roy4222/Roy-AmazingHand-SO101/AmazingHand_Enhanced/Demo/docs/finger.png

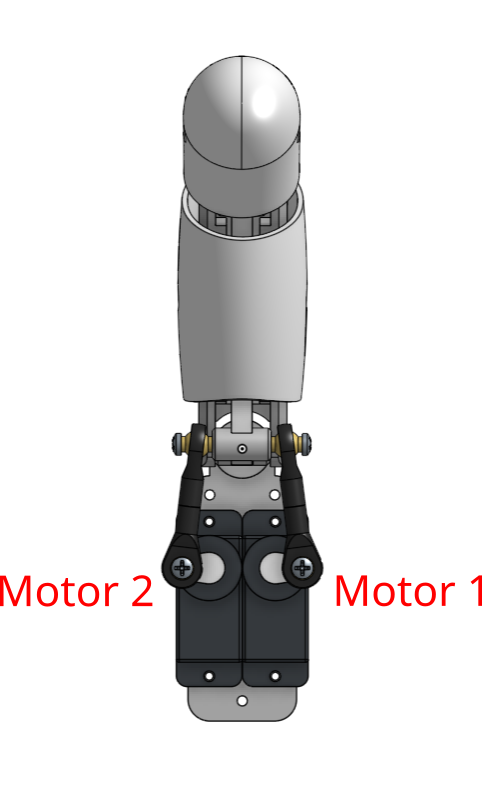
AmazingHand_Enhanced/Demo/docs/finger.png
