roy4222/Roy-AmazingHand-SO101/AmazingHand_Enhanced/Demo/docs/r_hand.png

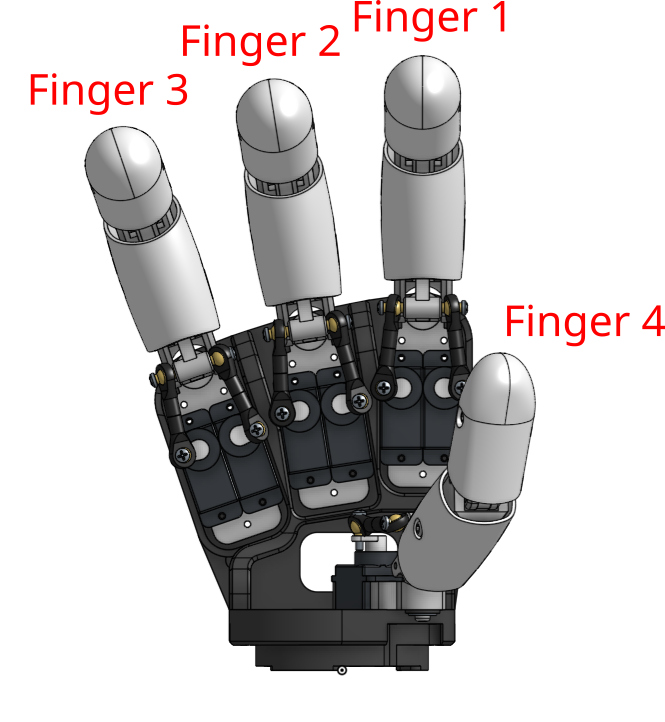
AmazingHand_Enhanced/Demo/docs/r_hand.png
