roy4222/Roy-AmazingHand-SO101/AmazingHand_Enhanced/cad/Step/Amazing Hand Enhanced Parts - R-Hand_Plate.step

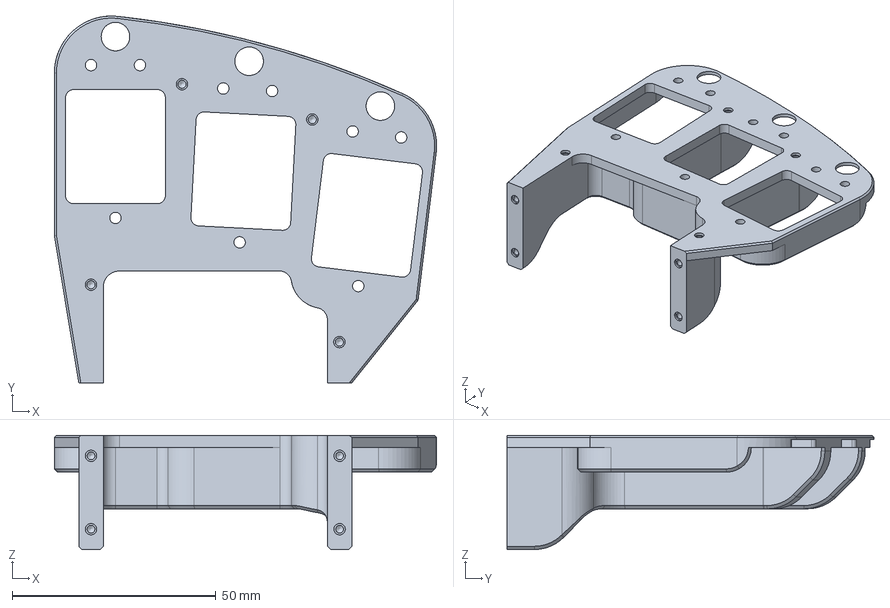
[picture p6: CAD file, 2026-04-02]
AmazingHand_Enhanced/cad/Step/Amazing Hand Enhanced Parts - R-Hand_Plate.step
93.8 x 90.1 x 28.0 mm
