roy4222/Roy-AmazingHand-SO101/AmazingHand_Enhanced/Demo/AHSimulation/AHSimulation/AH_Right/mjcf/assets/distal_shell.stl

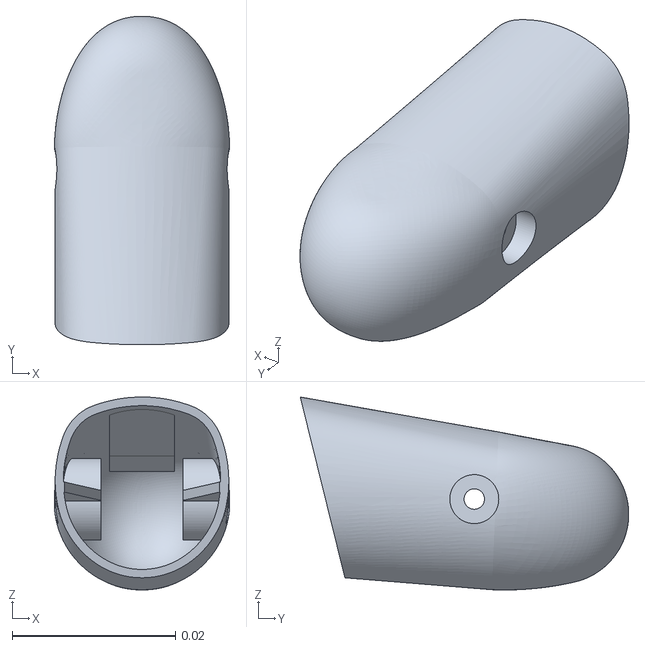
[picture p7: CAD file, 2026-04-08]
AmazingHand_Enhanced/Demo/AHSimulation/AHSimulation/AH_Right/mjcf/assets/distal_shell.stl
0.0215 x 0.0403 x 0.0237
