roy4222/Roy-AmazingHand-SO101/AmazingHand_Enhanced/cad/Step/Amazing Hand Enhanced Parts - Finger_Frame.step

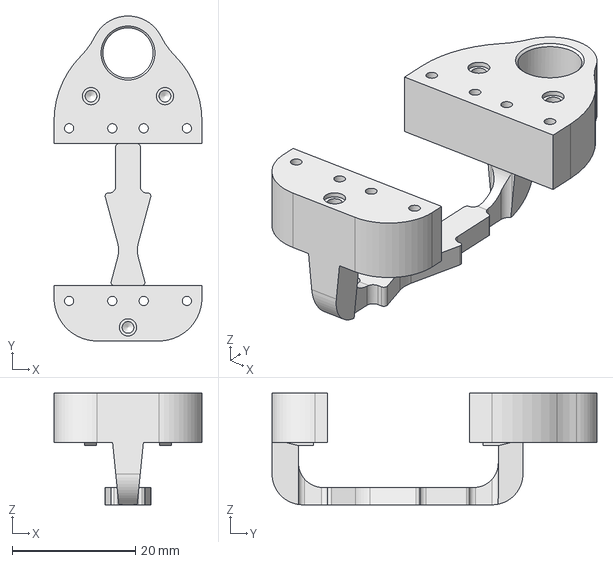
[picture p8: CAD file, 2026-04-02]
AmazingHand_Enhanced/cad/Step/Amazing Hand Enhanced Parts - Finger_Frame.step
24.0 x 52.7 x 18.1 mm
