roy4222/Roy-AmazingHand-SO101/AmazingHand_Enhanced/Demo/AHSimulation/AHSimulation/AH_Left/mjcf/assets/m2_rod_l18.stl

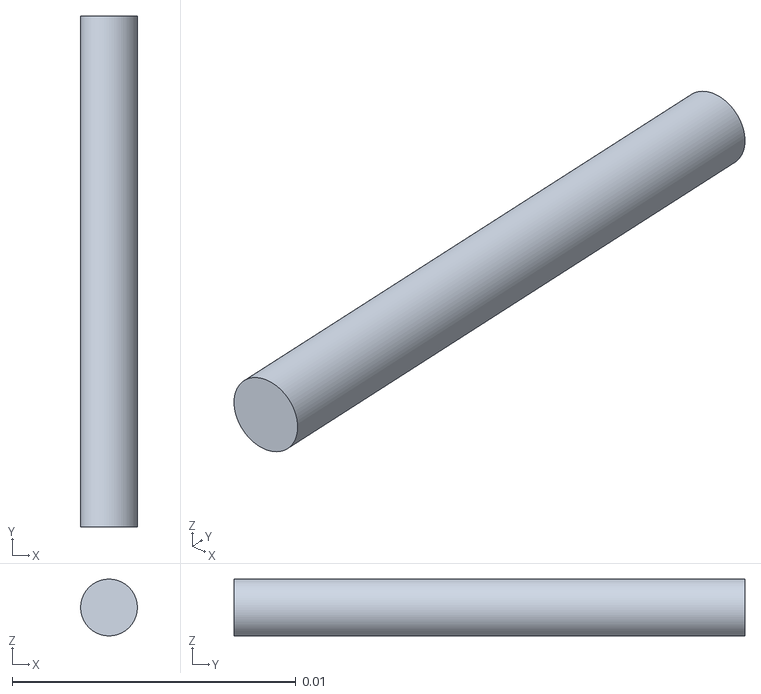
[picture p9: CAD file, 2026-04-08]
AmazingHand_Enhanced/Demo/AHSimulation/AHSimulation/AH_Left/mjcf/assets/m2_rod_l18.stl
0.002 x 0.018 x 0.002
