roy4222/Roy-AmazingHand-SO101/AmazingHand_Enhanced/Demo/AHSimulation/AHSimulation/AH_Right/mjcf/assets/custom_servo_horn.stl

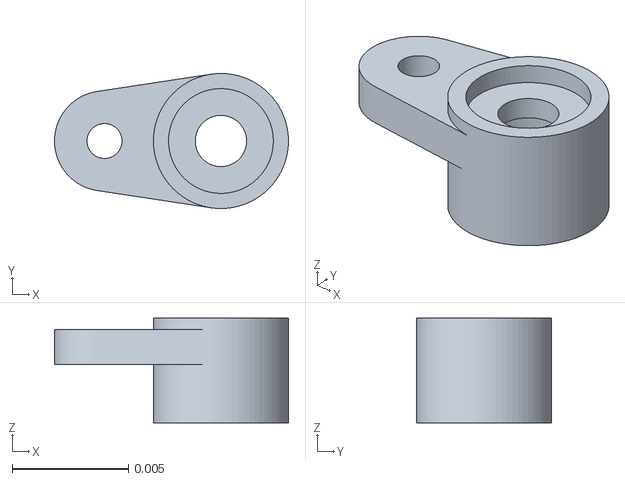
[picture p10: CAD file, 2026-04-08]
AmazingHand_Enhanced/Demo/AHSimulation/AHSimulation/AH_Right/mjcf/assets/custom_servo_horn.stl
0.01 x 0.0058 x 0.0045
