roy4222/Roy-AmazingHand-SO101/AmazingHand_Enhanced/cad/Step/Servo Horn - Custom_Servo-Horn.step

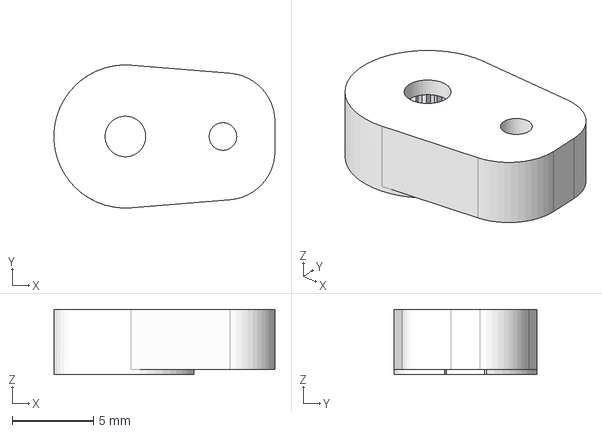
[picture p11: CAD file, 2026-04-02]
AmazingHand_Enhanced/cad/Step/Servo Horn - Custom_Servo-Horn.step
13.6 x 8.79 x 4.00 mm
