roy4222/Roy-AmazingHand-SO101/AmazingHand_Enhanced/Demo/AHSimulation/AHSimulation/AH_Left/mjcf/assets/finger_frame_1.stl

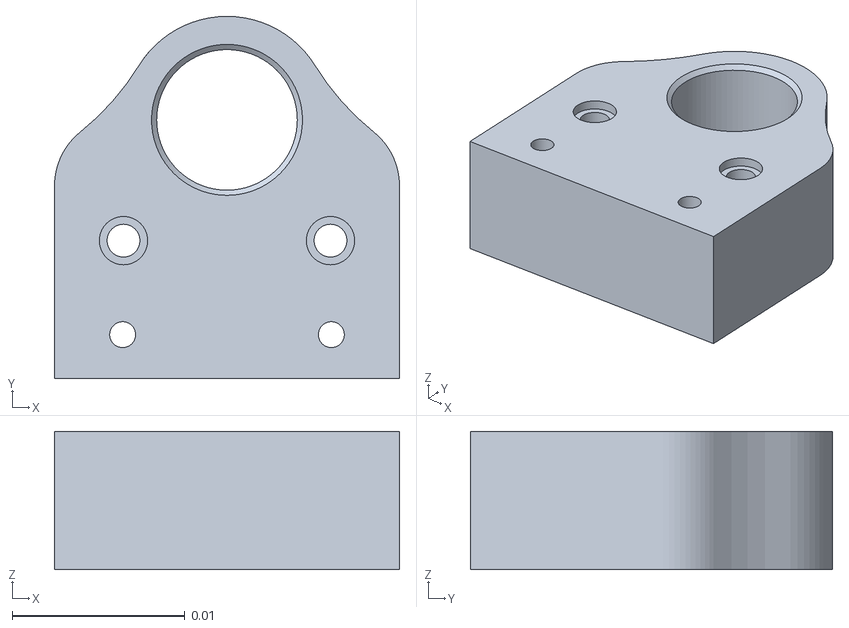
[picture p12: CAD file, 2026-04-08]
AmazingHand_Enhanced/Demo/AHSimulation/AHSimulation/AH_Left/mjcf/assets/finger_frame_1.stl
0.02 x 0.021 x 0.008
