roy4222/Roy-AmazingHand-SO101/AmazingHand_Enhanced/Demo/AHSimulation/AHSimulation/AH_Right/mjcf/assets/link.stl

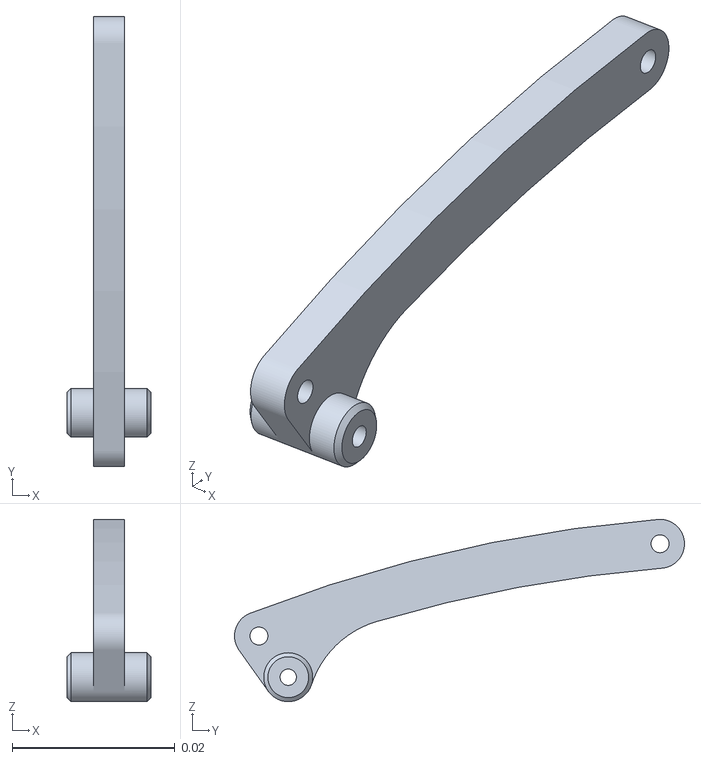
[picture p13: CAD file, 2026-04-08]
AmazingHand_Enhanced/Demo/AHSimulation/AHSimulation/AH_Right/mjcf/assets/link.stl
0.0103 x 0.0552 x 0.0224
