roy4222/Roy-AmazingHand-SO101/AmazingHand_Enhanced/cad/Step/Amazing Hand Enhanced Parts - R-Top_Shell.step

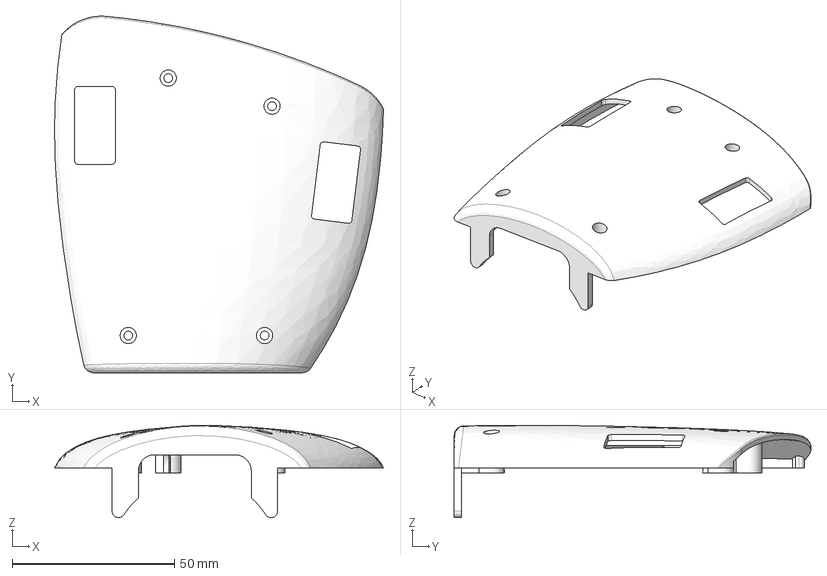
[picture p14: CAD file, 2026-04-02]
AmazingHand_Enhanced/cad/Step/Amazing Hand Enhanced Parts - R-Top_Shell.step
101.4 x 109.9 x 28.4 mm
