roy4222/Roy-AmazingHand-SO101/AmazingHand_Enhanced/Demo/AHSimulation/AHSimulation/AH_Right/mjcf/assets/rotule_lever.stl

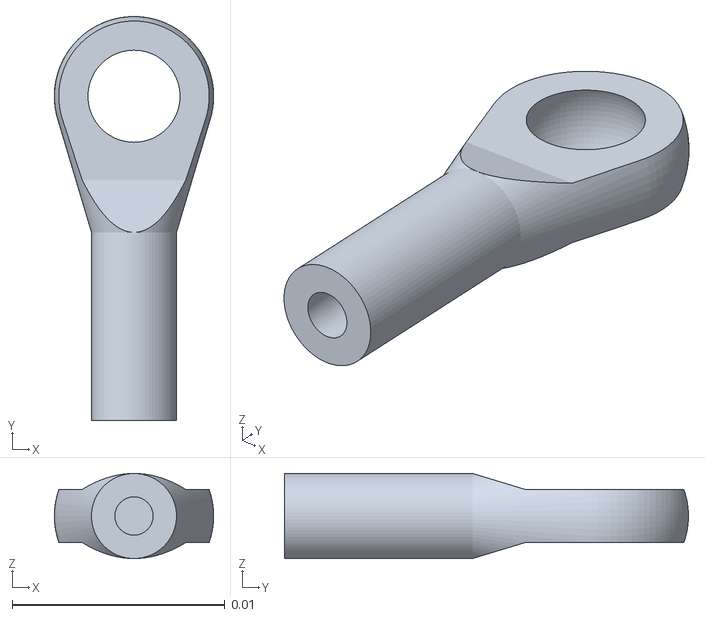
[picture p15: CAD file, 2026-04-08]
AmazingHand_Enhanced/Demo/AHSimulation/AHSimulation/AH_Right/mjcf/assets/rotule_lever.stl
0.0075 x 0.019 x 0.004
