roy4222/Roy-AmazingHand-SO101/AmazingHand_Enhanced/cad/Step/Amazing Hand Enhanced Parts - L-Wrist_Interface.step

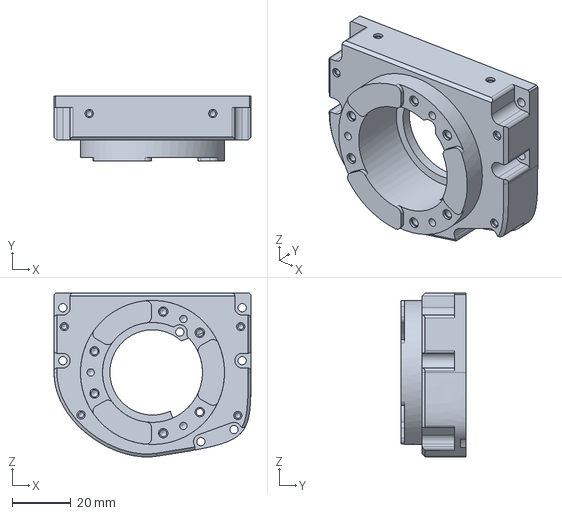
[picture p16: CAD file, 2026-04-02]
AmazingHand_Enhanced/cad/Step/Amazing Hand Enhanced Parts - L-Wrist_Interface.step
67.0 x 22.2 x 55.7 mm
