roy4222/Roy-AmazingHand-SO101/AmazingHand_Enhanced/Demo/AHSimulation/AHSimulation/AH_Left/mjcf/assets/spacer.stl

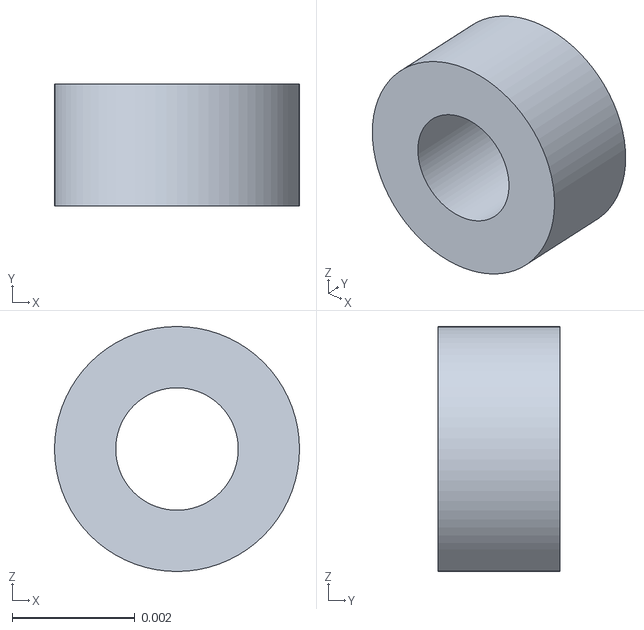
[picture p17: CAD file, 2026-04-08]
AmazingHand_Enhanced/Demo/AHSimulation/AHSimulation/AH_Left/mjcf/assets/spacer.stl
0.004 x 0.002 x 0.004
