roy4222/Roy-AmazingHand-SO101/AmazingHand_Enhanced/Demo/AHSimulation/AHSimulation/AH_Left/mjcf/assets/rotule_ball.stl

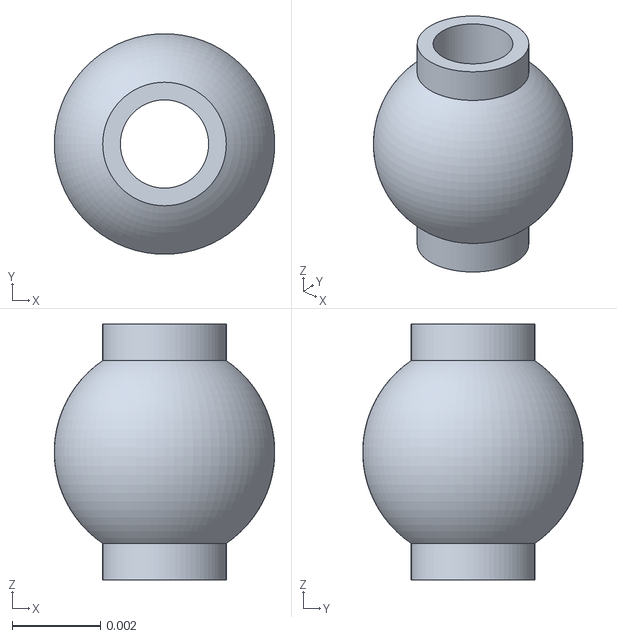
[picture p18: CAD file, 2026-04-08]
AmazingHand_Enhanced/Demo/AHSimulation/AHSimulation/AH_Left/mjcf/assets/rotule_ball.stl
0.005 x 0.005 x 0.0058
