roy4222/Roy-AmazingHand-SO101/AmazingHand_Enhanced/cad/Step/Amazing Hand Enhanced Parts - L-Palm_Shell.step

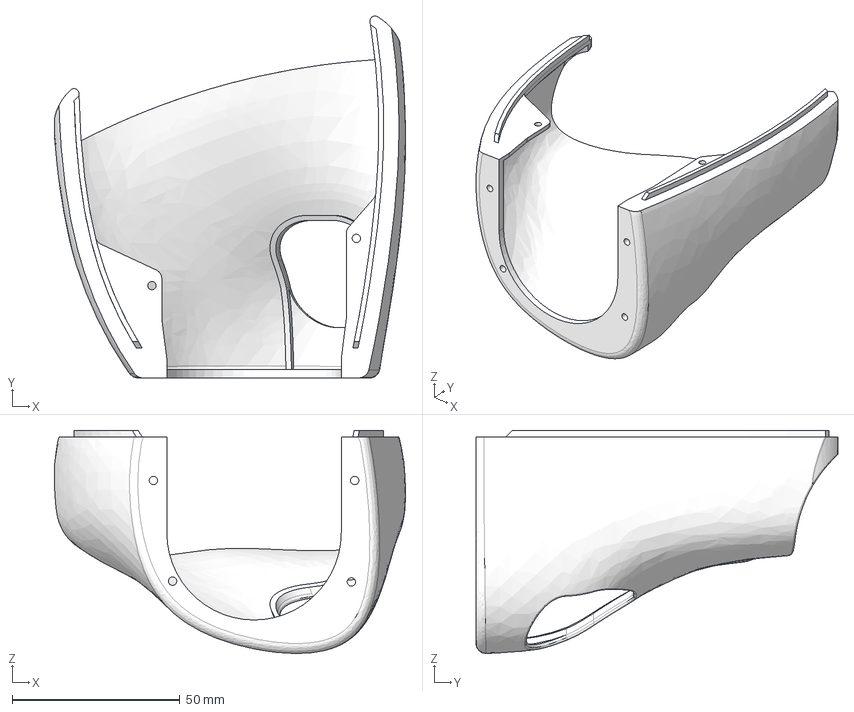
[picture p21: CAD file, 2026-04-02]
AmazingHand_Enhanced/cad/Step/Amazing Hand Enhanced Parts - L-Palm_Shell.step
104.7 x 107.9 x 66.5 mm
