roy4222/Roy-AmazingHand-SO101/AmazingHand_Enhanced/Demo/AHSimulation/AHSimulation/AH_Left/mjcf/assets/l_wrist_interface.stl

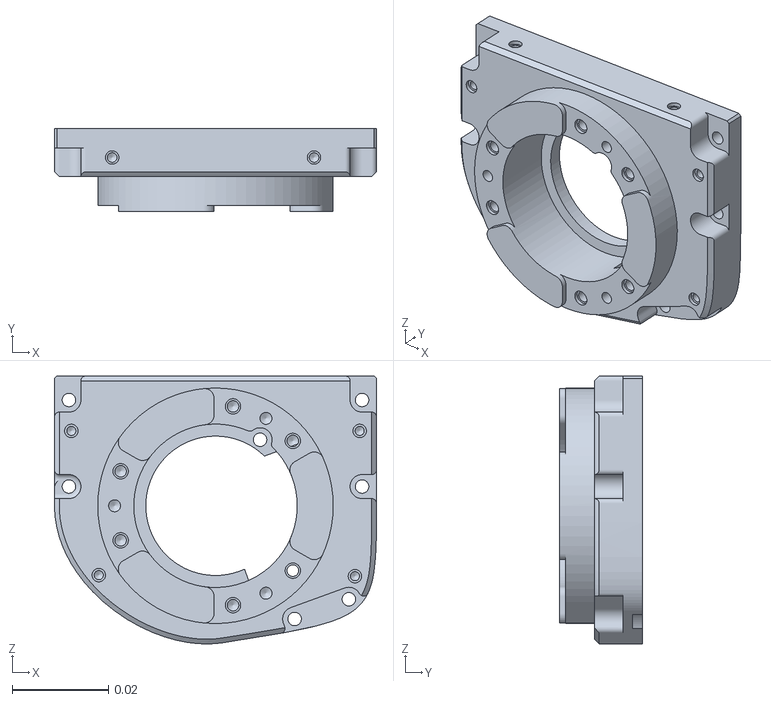
[picture p22: CAD file, 2026-04-08]
AmazingHand_Enhanced/Demo/AHSimulation/AHSimulation/AH_Left/mjcf/assets/l_wrist_interface.stl
0.067 x 0.0172 x 0.0558
