roy4222/Roy-AmazingHand-SO101/AmazingHand_Enhanced/Demo/AHSimulation/AHSimulation/AH_Left/mjcf/assets/parallel_pin_2_x_10__fee063fca0c8b40e46bbc4ffff61d999.stl

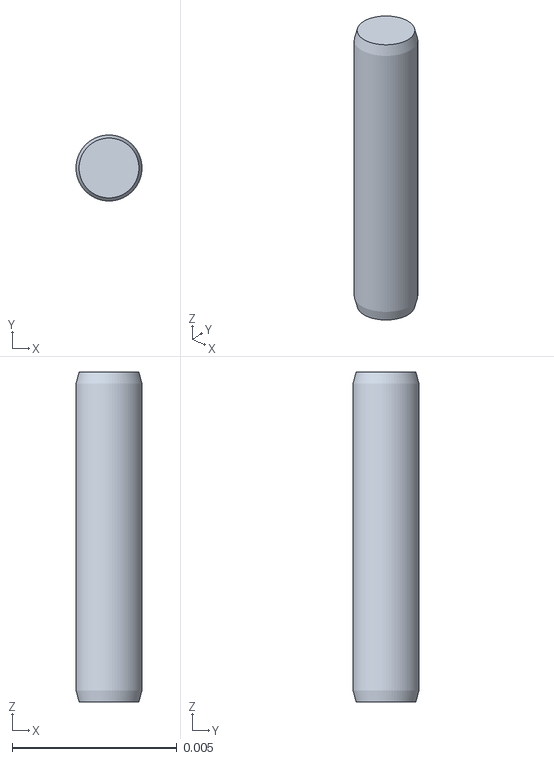
[picture p27: CAD file, 2026-04-08]
AmazingHand_Enhanced/Demo/AHSimulation/AHSimulation/AH_Left/mjcf/assets/parallel_pin_2_x_10__fee063fca0c8b40e46bbc4ffff61d999.stl
0.002 x 0.002 x 0.01
