roy4222/Roy-AmazingHand-SO101/AmazingHand_Enhanced/Demo/AHSimulation/AHSimulation/AH_Right/mjcf/assets/parallel_pin_2_x_16__da4b7ddbe9d803fe3fbc70f2e822b99b.stl

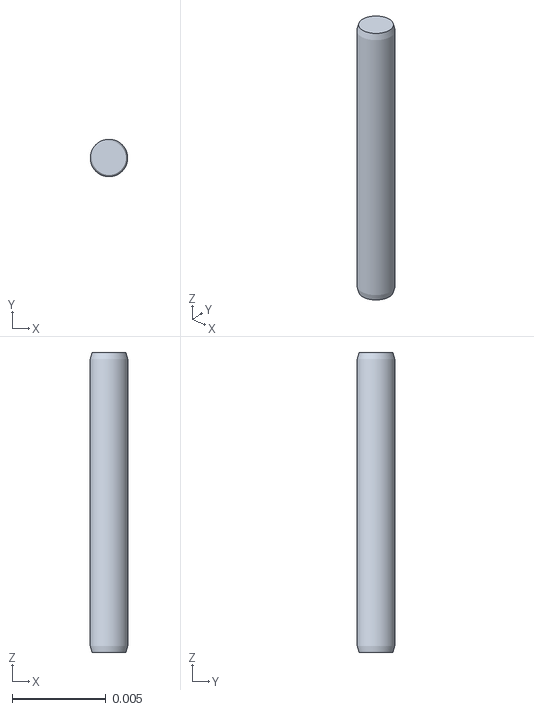
[picture p28: CAD file, 2026-04-08]
AmazingHand_Enhanced/Demo/AHSimulation/AHSimulation/AH_Right/mjcf/assets/parallel_pin_2_x_16__da4b7ddbe9d803fe3fbc70f2e822b99b.stl
0.002 x 0.002 x 0.016
