roy4222/Roy-AmazingHand-SO101/(list of files, cad)

Other CAD files:
AmazingHand_Enhanced/cad/Step/Amazing Hand Enhanced Parts - L-Hand_Plate.step
AmazingHand_Enhanced/cad/Step/Amazing Hand Enhanced Parts - L-Top_Shell.step
AmazingHand_Enhanced/cad/Step/Amazing Hand Enhanced Parts - R-Wrist_Interface.step
AmazingHand_Enhanced/cad/Step/Amazing Hand Enhanced Parts - R-Palm_Shell.step
AmazingHand_Enhanced/Demo/AHSimulation/AHSimulation/AH_Left/mjcf/assets/l_hand_plate.stl
AmazingHand_Enhanced/Demo/AHSimulation/AHSimulation/AH_Right/mjcf/assets/dist.stl
AmazingHand_Enhanced/Demo/AHSimulation/AHSimulation/AH_Right/mjcf/assets/prox.stl
AmazingHand_Enhanced/Demo/AHSimulation/AHSimulation/AH_Right/mjcf/assets/r_wrist_interface.stl
AmazingHand_Enhanced/Demo/AHSimulation/AHSimulation/AH_Left/mjcf/assets/ph_pan_head_screw_m2x0_40_x_10__2803432263e518bbd16bccbbef8784ed.stl
AmazingHand_Enhanced/Demo/AHSimulation/AHSimulation/AH_Left/mjcf/assets/plain_washer_large_grade_a_m2_5__9a369f0dc77bf9c598cdf3fb468977e5.stl
AmazingHand_Enhanced/Demo/AHSimulation/AHSimulation/AH_Left/mjcf/assets/std00333_plast_tcb_torx_2_5x8__configuration_copy_of_default.stl
AmazingHand_Enhanced/Demo/AHSimulation/AHSimulation/AH_Left/mjcf/assets/std00447_thermoplastique_m2_5x6__configuration_default.stl
AmazingHand_Enhanced/Demo/AHSimulation/AHSimulation/AH_Right/mjcf/assets/ph_pan_head_screw_m2x0_40_x_10__2803432263e518bbd16bccbbef8784ed.stl
AmazingHand_Enhanced/Demo/AHSimulation/AHSimulation/AH_Right/mjcf/assets/plain_washer_large_grade_a_m2_5__9a369f0dc77bf9c598cdf3fb468977e5.stl
AmazingHand_Enhanced/Demo/AHSimulation/AHSimulation/AH_Right/mjcf/assets/std00333_plast_tcb_torx_2_5x8__configuration_copy_of_default.stl
AmazingHand_Enhanced/Demo/AHSimulation/AHSimulation/AH_Right/mjcf/assets/std00447_thermoplastique_m2_5x6__configuration_default.stl
AmazingHand_Enhanced/cad/Stl/Amazing Hand Enhanced Parts - Finger_Frame.stl
AmazingHand_Enhanced/cad/Stl/Amazing Hand Enhanced Parts - L-Hand_Plate.stl
AmazingHand_Enhanced/cad/Stl/Amazing Hand Enhanced Parts - L-Top_Shell.stl
AmazingHand_Enhanced/cad/Stl/Amazing Hand Enhanced Parts - L-Wrist_Interface.stl
AmazingHand_Enhanced/cad/Stl/Amazing Hand Enhanced Parts - R-Hand_Plate.stl
AmazingHand_Enhanced/cad/Stl/Amazing Hand Enhanced Parts - R-Top_Shell.stl
AmazingHand_Enhanced/cad/Stl/Amazing Hand Enhanced Parts - R-Wrist_Interface.stl
AmazingHand_Enhanced/cad/Stl/Servo horn - Custom_Servo-Horn.stl
