roy4222/Roy-AmazingHand-SO101/AmazingHand_Enhanced/Demo/AHSimulation/AHSimulation/AH_Left/mjcf/robot.xml

<?xml version="1.0" ?>
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
<mujoco model="mjcf">
  <compiler angle="radian" meshdir="assets" autolimits="true"/>
  <default>
    <default class="mjcf">
      <joint frictionloss="0.1" armature="0.005"/>
      <position kp="50" dampratio="1"/>
      <default class="visual">
        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
      </default>
      <default class="collision">
        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
      </default>
    </default>
  </default>
  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
  <default>
    <default class="perfect_actuator">
      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
      <joint damping="0.095" frictionloss="0.001" armature="0.001" range="-1.5707963267948966 1.5707963267948966"/>
      <position kp="10.0" kv="0.0" forcerange="-10.0 10.0"/>
      <default class="chosen_actuator"/>
    </default>
    <default class="xc330m288t">
      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
      <joint damping="0.095" frictionloss="0.058" armature="0.0018"/>
      <position kp="2.54" kv="0.0" forcerange="-0.8 0.8"/>
    </default>
    <default class="sts3215_345">
      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
      <joint damping="0.56" frictionloss="0.068" armature="0.027"/>
      <position kp="17.11" kv="0.0" forcerange="-3.23 3.23"/>
    </default>
    <default class="sts3215_147">
      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
      <joint damping="0.1" frictionloss="0.028" armature="0.011"/>
      <position kp="17.11" kv="0.0" forcerange="-1.35 1.35"/>
    </default>
  </default>
  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
  <default>
    <equality solref="0.002 1" solimp="0.99 0.999 0.0005 0.5 2"/>
  </default>
  <worldbody>
    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
    <body name="l_wrist_interface" pos="0 0 0" quat="1 0 0 0" childclass="mjcf">
      <inertial pos="0 0 0" mass="1e-09" fullinertia="1e-09 1e-09 1e-09 0 0 0"/>
      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
      <body name="custom_servo_horn" pos="-0.00755 -0.01845 0.0698" quat="0.5 0.5 -0.5 -0.5">
        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
        <joint axis="0 0 1" name="finger1_motor1" type="hinge" range="-1.5707963267680816 1.5707963268217116"/>
        <inertial pos="-0.005 0 -0.00655938" mass="0.000410988" fullinertia="4.636e-09 4.636e-09 1e-09 -0 0 -0"/>
        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
        <body name="ball_link" pos="-0.005 0 -0.0069" quat="0.00510149 -0.888984 0.0544589 0.454661">
          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
          <joint axis="0 0 1" name="passive_ball1" type="ball"/>
          <inertial pos="-0 -0.0165 -0" mass="0.000463323" fullinertia="6.4012e-08 1.597e-09 6.4012e-08 0 -0 -0"/>
          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
          <body name="rotule_ball" pos="-0 -0.033 0" quat="0.707107 0 -0.707107 0">
            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
            <joint axis="0 0 1" name="passive_ball2" type="ball"/>
            <inertial pos="-0.0054579 -0.0141744 -0.00370248" mass="0.00277119" fullinertia="7.66485e-07 1.05617e-07 7.96842e-07 1.1411e-07 -1.279e-08 -3.7742e-08"/>
            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
            <body name="std00333_plast_tcb_torx_2_5x8__configuration_copy_of_default" pos="-0.0116897 -0.000368272 -0.00081146" quat="0.778258 -0.271383 0.369077 -0.429475">
              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
              <joint axis="0 0 1" name="passive2 (1)" type="hinge"/>
              <inertial pos="-0.00530874 -0.00868244 0.00225" mass="0.00201325" fullinertia="9.3448e-08 4.6901e-08 1.16807e-07 -4.5453e-08 -0 0"/>
              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
            </body>
            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
            <body name="parallel_pin_2_x_10__fee063fca0c8b40e46bbc4ffff61d999" pos="0.00373407 -0.0482013 -0.00704062" quat="0.271383 0.778258 -0.429475 -0.369077">
              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
              <joint axis="0 0 1" name="passive4 (1)" type="hinge"/>
              <inertial pos="0.014571 -0.0133924 0.00225" mass="0.00540375" fullinertia="3.60212e-07 5.51031e-07 7.69492e-07 3.36413e-07 0 0"/>
              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
              <body name="parallel_pin_2_x_16__da4b7ddbe9d803fe3fbc70f2e822b99b" pos="-0.000346366 -0.00598999 0.00655" quat="0 -0.999998 -0.00198164 -0">
                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
                <joint axis="0 0 1" name="passive_5 (1)" type="hinge"/>
                <inertial pos="-0.0249171 -0.00392936 0.0052354" mass="0.0101851" fullinertia="4.96149e-07 2.52849e-06 2.3577e-06 2.4514e-08 1.19e-10 3.04e-10"/>
                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
              </body>
            </body>
          </body>
        </body>
      </body>
      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
      <body name="rotule_ball_2" pos="-0.00755 -0.03055 0.0698" quat="0.5 -0.5 -0.5 0.5">
        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
        <joint axis="0 0 1" name="finger1_motor2" type="hinge" range="-1.570796326794806 1.5707963267949872"/>
        <inertial pos="-0.005 0 -0.00655938" mass="0.000410988" fullinertia="4.636e-09 4.636e-09 1e-09 -0 0 0"/>
        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
        <body name="m2_rod_l18" pos="-0.005 -0 -0.0069" quat="0.413519 -0.0282313 0.909382 0.0350781">
          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
          <joint axis="0 0 1" name="passive_ball3" type="ball"/>
          <inertial pos="-0 -0.0165 -0" mass="0.000463323" fullinertia="6.4012e-08 1.597e-09 6.4012e-08 0 -0 -0"/>
          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
        </body>
      </body>
      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
      <body name="custom_servo_horn_2" pos="-0.00755 0.0109301 0.0632994" quat="0.525483 0.473147 -0.525483 -0.473147">
        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
        <joint axis="0 0 1" name="finger2_motor1" type="hinge" range="-1.5707963267948992 1.570796326794894"/>
        <inertial pos="-0.005 0 -0.00655938" mass="0.000410988" fullinertia="4.636e-09 4.636e-09 1e-09 -0 0 -0"/>
        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
        <body name="ball_link_2" pos="-0.005 0 -0.0069" quat="0.050917 0.0053796 0.0199815 0.998488">
          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
          <joint axis="0 0 1" name="passive_ball4" type="ball"/>
          <inertial pos="-0 -0.0165 -0" mass="0.000463323" fullinertia="6.4012e-08 1.597e-09 6.4012e-08 0 -0 -0"/>
          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
          <body name="rotule_ball_3" pos="-0 -0.033 -0" quat="0.707107 -0 -0.707107 -0">
            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
            <joint axis="0 0 1" name="passive_ball5" type="ball"/>
            <inertial pos="0.000263719 -0.0141744 0.00658995" mass="0.00277119" fullinertia="7.98353e-07 1.05617e-07 7.64973e-07 -9.8146e-08 -1.0743e-08 -6.9375e-08"/>
            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
            <body name="std00333_plast_tcb_torx_2_5x8__configuration_copy_of_default_2" pos="0.00629123 -0.000368272 0.00988571" quat="0.0211395 -0.505685 0.861078 0.0487841">
              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
              <joint axis="0 0 1" name="passive2 (2)" type="hinge"/>
              <inertial pos="-0.00530874 -0.00868244 0.00225" mass="0.00201325" fullinertia="9.3448e-08 4.6901e-08 1.16807e-07 -4.5453e-08 -0 -0"/>
              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
            </body>
            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
            <body name="parallel_pin_2_x_10__fee063fca0c8b40e46bbc4ffff61d999_2" pos="-0.00788193 -0.0482013 0.00117849" quat="0.505685 0.0211395 0.0487841 -0.861078">
              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
              <joint axis="0 0 1" name="passive4 (2)" type="hinge"/>
              <inertial pos="0.014571 -0.0133924 0.00225" mass="0.00540375" fullinertia="3.60212e-07 5.51031e-07 7.69492e-07 3.36413e-07 -0 -0"/>
              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
              <body name="parallel_pin_2_x_16__da4b7ddbe9d803fe3fbc70f2e822b99b_2" pos="-0.000346366 -0.00598999 0.00655" quat="0 0.999998 0.00198164 -0">
                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
                <joint axis="0 0 1" name="passive_5 (2)" type="hinge"/>
                <inertial pos="-0.0249171 -0.00392936 0.0052354" mass="0.0101851" fullinertia="4.96149e-07 2.52849e-06 2.3577e-06 2.4514e-08 1.19e-10 3.04e-10"/>
                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
              </body>
            </body>
          </body>
        </body>
      </body>
      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
      <body name="rotule_ball_4" pos="-0.00755 -0.00110358 0.0645642" quat="0.473147 -0.525483 -0.473147 0.525483">
        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
        <joint axis="0 0 1" name="finger2_motor2" type="hinge" range="-1.570796326794869 1.570796326794924"/>
        <inertial pos="-0.005 0 -0.00655938" mass="0.000410988" fullinertia="4.636e-09 4.636e-09 1e-09 -0 -0 0"/>
        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
          <inertial pos="-0 -0.0165 -0" mass="0.000463323" fullinertia="6.4012e-08 1.597e-09 6.4012e-08 0 -0 -0"/>
          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
          <body name="rotule_ball_7" pos="-0 -0.033 -0" quat="0.707107 -0 -0.707107 0">
            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
            <joint axis="0 0 1" name="passive_ball11" type="ball"/>
            <inertial pos="0.00035539 -0.0141744 -0.00658564" mass="0.00277119" fullinertia="8.00066e-07 1.05617e-07 7.63261e-07 9.1208e-08 -7.438e-09 7.8273e-08"/>
            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
            <body name="std00333_plast_tcb_torx_2_5x8__configuration_copy_of_default_4" pos="-0.00533652 -0.000368272 -0.0104321" quat="0.859137 -0.0249949 -0.0615329 -0.507417">
              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
              <joint axis="0 0 1" name="passive2 (4)" type="hinge"/>
              <inertial pos="-0.00530874 -0.00868244 0.00225" mass="0.00201325" fullinertia="9.3448e-08 4.6901e-08 1.16807e-07 -4.5453e-08 -0 -0"/>
              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
            </body>
            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
            <body name="parallel_pin_2_x_10__fee063fca0c8b40e46bbc4ffff61d999_4" pos="0.00795771 -0.0482013 -0.000434197" quat="0.0249949 0.859137 -0.507417 0.0615329">
              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
              <joint axis="0 0 1" name="passive4 (4)" type="hinge"/>
              <inertial pos="0.014571 -0.0133924 0.00225" mass="0.00540375" fullinertia="3.60212e-07 5.51031e-07 7.69492e-07 3.36413e-07 0 0"/>
              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
              <body name="parallel_pin_2_x_16__da4b7ddbe9d803fe3fbc70f2e822b99b_4" pos="-0.000346366 -0.00598999 0.00655" quat="0 -0.999998 -0.00198164 -0">
                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
                <joint axis="0 0 1" name="passive_5 (4)" type="hinge"/>
                <inertial pos="-0.0249171 -0.00392936 0.0052354" mass="0.0101851" fullinertia="4.96149e-07 2.52849e-06 2.3577e-06 2.4514e-08 1.19e-10 3.04e-10"/>
                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
              </body>
            </body>
          </body>
        </body>
      </body>
      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
      <body name="rotule_ball_8" pos="-0.000298971 -0.00773341 0.03365" quat="0 -0.573576 0.819152 -0">
        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
        <joint axis="0 0 1" name="finger4_motor2" type="hinge" range="-1.5707963270150649 1.5707963265747282"/>
        <inertial pos="-0.005 0 -0.00655938" mass="0.000410988" fullinertia="4.636e-09 4.636e-09 1e-09 0 0 -0"/>
        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
        <body name="ball_link_7" pos="-0.005 0 -0.0069" quat="0.0108535 -0.0399969 0.998927 0.0206815">
          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
          <joint axis="0 0 1" name="passive_ball12" type="ball"/>
          <inertial pos="-0 -0.0165 -0" mass="0.000463323" fullinertia="6.4012e-08 1.597e-09 6.4012e-08 0 -0 -0"/>
          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
        </body>
      </body>
    </body>
  </worldbody>
  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
  <actuator>
    <position class="mjcf" name="finger1_motor1" joint="finger1_motor1" inheritrange="1"/>
    <position class="mjcf" name="finger1_motor2" joint="finger1_motor2" inheritrange="1"/>
    <position class="mjcf" name="finger2_motor1" joint="finger2_motor1" inheritrange="1"/>
    <position class="mjcf" name="finger2_motor2" joint="finger2_motor2" inheritrange="1"/>
    <position class="mjcf" name="finger3_motor1" joint="finger3_motor1" inheritrange="1"/>
    <position class="mjcf" name="finger3_motor2" joint="finger3_motor2" inheritrange="1"/>
    <position class="mjcf" name="finger4_motor1" joint="finger4_motor1" inheritrange="1"/>
    <position class="mjcf" name="finger4_motor2" joint="finger4_motor2" inheritrange="1"/>
  </actuator>
  <equality>
    <connect site1="closing_1 (1)_1" site2="closing_1 (1)_2"/>
    <connect site1="closing_1 (1)_1_z" site2="closing_1 (1)_2_z"/>
    <connect site1="closing_3 (1)_1" site2="closing_3 (1)_2"/>
    <connect site1="closing_3 (1)_1_z" site2="closing_3 (1)_2_z"/>
    <connect site1="closing_1 (2)_1" site2="closing_1 (2)_2"/>
    <connect site1="closing_1 (2)_1_z" site2="closing_1 (2)_2_z"/>
    <connect site1="closing_3 (2)_1" site2="closing_3 (2)_2"/>
    <connect site1="closing_3 (2)_1_z" site2="closing_3 (2)_2_z"/>
    <connect site1="closing_1 (3)_1" site2="closing_1 (3)_2"/>
    <connect site1="closing_1 (3)_1_z" site2="closing_1 (3)_2_z"/>
    <connect site1="closing_3 (3)_1" site2="closing_3 (3)_2"/>
    <connect site1="closing_3 (3)_1_z" site2="closing_3 (3)_2_z"/>
    <connect site1="closing_1 (4)_1" site2="closing_1 (4)_2"/>
    <connect site1="closing_1 (4)_1_z" site2="closing_1 (4)_2_z"/>
    <connect site1="closing_3 (4)_1" site2="closing_3 (4)_2"/>
    <connect site1="closing_3 (4)_1_z" site2="closing_3 (4)_2_z"/>
    <connect site1="closing_ball1_1" site2="closing_ball1_2"/>
    <connect site1="closing_ball2_1" site2="closing_ball2_2"/>
    <connect site1="closing_ball3_1" site2="closing_ball3_2"/>
    <connect site1="closing_ball4_1" site2="closing_ball4_2"/>
  </equality>
</mujoco>
