roy4222/Roy-AmazingHand-SO101/AmazingHand_Enhanced/Demo/AHSimulation/AHSimulation/AH_Right/mjcf/robot.xml

<?xml version="1.0" ?>
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
<mujoco model="mjcf">
  <compiler angle="radian" meshdir="assets" autolimits="true"/>
  <default>
    <default class="mjcf">
      <joint frictionloss="0.1" armature="0.005"/>
      <position kp="50" dampratio="1"/>
      <default class="visual">
        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
      </default>
      <default class="collision">
        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
      </default>
    </default>
  </default>
  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
  <default>
    <default class="perfect_actuator">
      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
      <joint damping="0.095" frictionloss="0.001" armature="0.001" range="-1.5707963267948966 1.5707963267948966"/>
      <position kp="10.0" kv="0.0" forcerange="-10.0 10.0"/>
      <default class="chosen_actuator"/>
    </default>
    <default class="xc330m288t">
      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
      <joint damping="0.095" frictionloss="0.058" armature="0.0018"/>
      <position kp="2.54" kv="0.0" forcerange="-0.8 0.8"/>
    </default>
    <default class="sts3215_345">
      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
      <joint damping="0.56" frictionloss="0.068" armature="0.027"/>
      <position kp="17.11" kv="0.0" forcerange="-3.23 3.23"/>
    </default>
    <default class="sts3215_147">
      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
      <joint damping="0.1" frictionloss="0.028" armature="0.011"/>
      <position kp="17.11" kv="0.0" forcerange="-1.35 1.35"/>
    </default>
  </default>
  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
  <default>
    <equality solref="0.002 1" solimp="0.99 0.999 0.0005 0.5 2"/>
  </default>
  <worldbody>
    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
    <body name="r_wrist_interface" pos="0 0 0" quat="1 0 0 0" childclass="mjcf">
      <inertial pos="0 0 0" mass="1e-09" fullinertia="1e-09 1e-09 1e-09 0 0 0"/>
      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
      <body name="custom_servo_horn" pos="-0.00755 0.03055 0.0698" quat="0.5 0.5 -0.5 -0.5">
        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
        <joint axis="0 0 1" name="finger1_motor1" type="hinge" range="-1.570796326768256 1.570796326821537"/>
        <inertial pos="-0.005 1.45507e-17 -0.00655938" mass="0.000410988" fullinertia="4.63584e-09 4.63584e-09 1e-09 -5.13695e-25 3.61104e-25 -1.47358e-24"/>
        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
        <body name="ball_link" pos="-0.005 1.94289e-16 -0.0069" quat="0.00510149 -0.888984 0.0544589 0.454661">
          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
          <joint axis="0 0 1" name="passive_ball1" type="ball"/>
          <inertial pos="-1.37305e-13 -0.0165 -1.37299e-13" mass="0.000463323" fullinertia="6.40121e-08 1.59688e-09 6.40121e-08 6.66021e-19 -4.97671e-14 -6.66027e-19"/>
          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
          <body name="rotule_ball" pos="-1.04083e-17 -0.033 0" quat="0.707107 -1.63345e-17 -0.707107 2.5537e-16">
            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
            <joint axis="0 0 1" name="passive_ball2" type="ball"/>
            <inertial pos="-0.0054579 -0.0141744 -0.00370248" mass="0.00277119" fullinertia="7.66485e-07 1.05617e-07 7.96842e-07 1.1411e-07 -1.27899e-08 -3.77417e-08"/>
            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
            <body name="std00333_plast_tcb_torx_2_5x8__configuration_copy_of_default" pos="-0.0116897 -0.000368272 -0.00081146" quat="0.778258 -0.271383 0.369077 -0.429475">
              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
              <joint axis="0 0 1" name="passive2 (1)" type="hinge"/>
              <inertial pos="-0.00530874 -0.00868244 0.00225" mass="0.00201325" fullinertia="9.34482e-08 4.69015e-08 1.16807e-07 -4.54529e-08 -5.37151e-21 1.88891e-21"/>
              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
            </body>
            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
            <body name="parallel_pin_2_x_10__fee063fca0c8b40e46bbc4ffff61d999" pos="0.00373407 -0.0482013 -0.00704062" quat="0.271383 0.778258 -0.429475 -0.369077">
              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
              <joint axis="0 0 1" name="passive4 (1)" type="hinge"/>
              <inertial pos="0.014571 -0.0133924 0.00225" mass="0.00540375" fullinertia="3.60212e-07 5.51031e-07 7.69492e-07 3.36413e-07 4.59414e-20 6.20919e-20"/>
              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
              <body name="parallel_pin_2_x_16__da4b7ddbe9d803fe3fbc70f2e822b99b" pos="-0.000346366 -0.00598999 0.00655" quat="1.92225e-14 -0.999998 -0.00198164 -2.35427e-14">
                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
                <joint axis="0 0 1" name="passive_5 (1)" type="hinge"/>
                <inertial pos="-0.0249171 -0.00392936 0.0052354" mass="0.0101851" fullinertia="4.96149e-07 2.52849e-06 2.3577e-06 2.45138e-08 1.19032e-10 3.03943e-10"/>
                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
              </body>
            </body>
          </body>
        </body>
      </body>
      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
      <body name="rotule_ball_2" pos="-0.00755 0.01845 0.0698" quat="0.5 -0.5 -0.5 0.5">
        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
        <joint axis="0 0 1" name="finger1_motor2" type="hinge" range="-1.5707963267948883 1.5707963267949048"/>
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
          <joint axis="0 0 1" name="passive_ball9" type="ball"/>
          <inertial pos="-1.37303e-13 -0.0165 -1.37299e-13" mass="0.000463323" fullinertia="6.40121e-08 1.59688e-09 6.40121e-08 6.66105e-19 -4.97671e-14 -6.66013e-19"/>
          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
        </body>
      </body>
      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
      <body name="custom_servo_horn_4" pos="-0.000298971 0.00773341 0.03365" quat="1.09642e-15 0.573573 0.819154 2.26766e-16">
        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
        <joint axis="0 0 1" name="finger4_motor1" type="hinge" range="-1.5707889966987234 1.5708036568910697"/>
        <inertial pos="-0.005 1.34196e-17 -0.00655938" mass="0.000410988" fullinertia="4.63584e-09 4.63584e-09 1e-09 -8.22944e-25 -2.0357e-26 -1.90632e-25"/>
        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
        <body name="ball_link_6" pos="-0.005 2.72785e-16 -0.0069" quat="0.0229055 0.997115 -0.0496666 0.0526352">
          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
          <joint axis="0 0 1" name="passive_ball10" type="ball"/>
          <inertial pos="-1.37301e-13 -0.0165 -1.37289e-13" mass="0.000463323" fullinertia="6.40121e-08 1.59688e-09 6.40121e-08 6.66024e-19 -4.97671e-14 -6.6601e-19"/>
          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
          <body name="rotule_ball_7" pos="-3.46945e-18 -0.033 1.38778e-17" quat="0.707107 -3.92857e-17 -0.707107 1.93508e-16">
            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
            <joint axis="0 0 1" name="passive_ball11" type="ball"/>
            <inertial pos="0.000502397 -0.0141744 -0.00657609" mass="0.00277119" fullinertia="8.0038e-07 1.05616e-07 7.62947e-07 8.94343e-08 -6.60789e-09 8.02893e-08"/>
            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
            <body name="std00333_plast_tcb_torx_2_5x8__configuration_copy_of_default_4" pos="-0.00510212 -0.000368231 -0.0105487" quat="0.858395 -0.0193237 -0.0711263 -0.507666">
              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
              <joint axis="0 0 1" name="passive2 (4)" type="hinge"/>
              <inertial pos="-0.00530871 -0.00868246 0.00225" mass="0.00201325" fullinertia="9.34485e-08 4.69012e-08 1.16807e-07 -4.54527e-08 2.07493e-23 -3.80521e-22"/>
              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
            </body>
            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
            <body name="parallel_pin_2_x_10__fee063fca0c8b40e46bbc4ffff61d999_4" pos="0.00796529 -0.0482013 -0.000256421" quat="0.0193237 0.858395 -0.507666 0.0711263">
              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
              <joint axis="0 0 1" name="passive4 (4)" type="hinge"/>
              <inertial pos="0.0145711 -0.0133923 0.00225" mass="0.00540375" fullinertia="3.6021e-07 5.51033e-07 7.69492e-07 3.36412e-07 9.8633e-21 -8.79128e-21"/>
              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
              <body name="parallel_pin_2_x_16__da4b7ddbe9d803fe3fbc70f2e822b99b_4" pos="-0.00034635 -0.00599 0.00655" quat="1.30622e-14 0.999998 0.00198154 -2.18286e-14">
                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
                <joint axis="0 0 1" name="passive_5 (4)" type="hinge"/>
                <inertial pos="-0.0249171 -0.00392936 0.0052354" mass="0.0101851" fullinertia="4.96149e-07 2.52849e-06 2.3577e-06 2.45138e-08 1.19032e-10 3.03943e-10"/>
                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
              </body>
            </body>
          </body>
        </body>
      </body>
      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
      <body name="rotule_ball_8" pos="-0.00443741 0.0191037 0.03365" quat="1.42065e-15 -0.819152 0.573576 6.98838e-17">
        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
        <joint axis="0 0 1" name="finger4_motor2" type="hinge" range="-1.5707963267948957 1.5707963267948974"/>
        <inertial pos="-0.005 1.88698e-17 -0.00655938" mass="0.000410988" fullinertia="4.63584e-09 4.63584e-09 1e-09 -4.00135e-25 1.5509e-24 -3.69519e-24"/>
        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
        <body name="ball_link_7" pos="-0.005 1.56125e-17 -0.0069" quat="0.000140654 -0.0402164 0.998986 0.0202514">
          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
          <joint axis="0 0 1" name="passive_ball12" type="ball"/>
          <inertial pos="-1.37306e-13 -0.0165 -1.37298e-13" mass="0.000463323" fullinertia="6.40121e-08 1.59688e-09 6.40121e-08 6.66017e-19 -4.97671e-14 -6.66019e-19"/>
          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
        </body>
      </body>
    </body>
  </worldbody>
  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
  <actuator>
    <position class="mjcf" name="finger1_motor1" joint="finger1_motor1" inheritrange="1"/>
    <position class="mjcf" name="finger1_motor2" joint="finger1_motor2" inheritrange="1"/>
    <position class="mjcf" name="finger2_motor1" joint="finger2_motor1" inheritrange="1"/>
    <position class="mjcf" name="finger2_motor2" joint="finger2_motor2" inheritrange="1"/>
    <position class="mjcf" name="finger3_motor1" joint="finger3_motor1" inheritrange="1"/>
    <position class="mjcf" name="finger3_motor2" joint="finger3_motor2" inheritrange="1"/>
    <position class="mjcf" name="finger4_motor1" joint="finger4_motor1" inheritrange="1"/>
    <position class="mjcf" name="finger4_motor2" joint="finger4_motor2" inheritrange="1"/>
  </actuator>
  <equality>
    <connect site1="closing_1 (1)_1" site2="closing_1 (1)_2"/>
    <connect site1="closing_1 (1)_1_z" site2="closing_1 (1)_2_z"/>
    <connect site1="closing_3 (1)_1" site2="closing_3 (1)_2"/>
    <connect site1="closing_3 (1)_1_z" site2="closing_3 (1)_2_z"/>
    <connect site1="closing_1 (2)_1" site2="closing_1 (2)_2"/>
    <connect site1="closing_1 (2)_1_z" site2="closing_1 (2)_2_z"/>
    <connect site1="closing_3 (2)_1" site2="closing_3 (2)_2"/>
    <connect site1="closing_3 (2)_1_z" site2="closing_3 (2)_2_z"/>
    <connect site1="closing_1 (3)_1" site2="closing_1 (3)_2"/>
    <connect site1="closing_1 (3)_1_z" site2="closing_1 (3)_2_z"/>
    <connect site1="closing_3 (3)_1" site2="closing_3 (3)_2"/>
    <connect site1="closing_3 (3)_1_z" site2="closing_3 (3)_2_z"/>
    <connect site1="closing_1 (4)_1" site2="closing_1 (4)_2"/>
    <connect site1="closing_1 (4)_1_z" site2="closing_1 (4)_2_z"/>
    <connect site1="closing_3 (4)_1" site2="closing_3 (4)_2"/>
    <connect site1="closing_3 (4)_1_z" site2="closing_3 (4)_2_z"/>
    <connect site1="closing_ball1_1" site2="closing_ball1_2"/>
    <connect site1="closing_ball2_1" site2="closing_ball2_2"/>
    <connect site1="closing_ball3_1" site2="closing_ball3_2"/>
    <connect site1="closing_ball4_1" site2="closing_ball4_2"/>
  </equality>
</mujoco>
