roy4222/Roy-AmazingHand-SO101/(commit log)

2026-02-16 Add filter + modify control
2026-04-02 Creation of new folder with AmzingHand+ details
    Read me for Amazing Hand +
    Specific parts
    Specific assembly steps
    Basic Demo
    [Amazing Hand+ Parts - Finger_Frame.step, Amazing Hand+ Parts - Finger_Frame.stl, Amazing Hand+ Parts - L-Hand_Plate.step, Amazing Hand+ Parts - L-Hand_Plate.stl, Amazing Hand+ Parts - L-Palm_Shell.step, Amazing Hand+ Parts - L-Top_Shell.step, Amazing Hand+ Parts - L-Top_Shell.stl, Amazing Hand+ Parts - L-Wrist_Interface.step]
2026-04-02 URL bug solved
    [Amazing Hand Enhanced Parts - Finger_Frame.step, Amazing Hand Enhanced Parts - Finger_Frame.stl, Amazing Hand Enhanced Parts - L-Hand_Plate.step, Amazing Hand Enhanced Parts - L-Hand_Plate.stl, Amazing Hand Enhanced Parts - L-Palm_Shell.step, Amazing Hand Enhanced Parts - L-Top_Shell.step, Amazing Hand Enhanced Parts - L-Top_Shell.stl, Amazing Hand Enhanced Parts - L-Wrist_Interface.step]
2026-04-08 Add Demo
    [additional.xml, bushing_0608_04.stl, custom_servo_horn.stl, dist.stl, dist_shell.stl, distal.stl, distal_shell.stl, finger_frame_1.stl]
2026-04-08 Update left hand robot.xml
    [robot.xml]
