roy4222/Roy-AmazingHand-SO101/(notices)

Notices in the files:
AmazingHand_Enhanced/README.md:
CC BY 4.0
